Patsko/PTSK-MIDI-Switchboard-PCB/switchboard 2.brd

## EAGLE design switchboard 2.brd (2018-03-31)

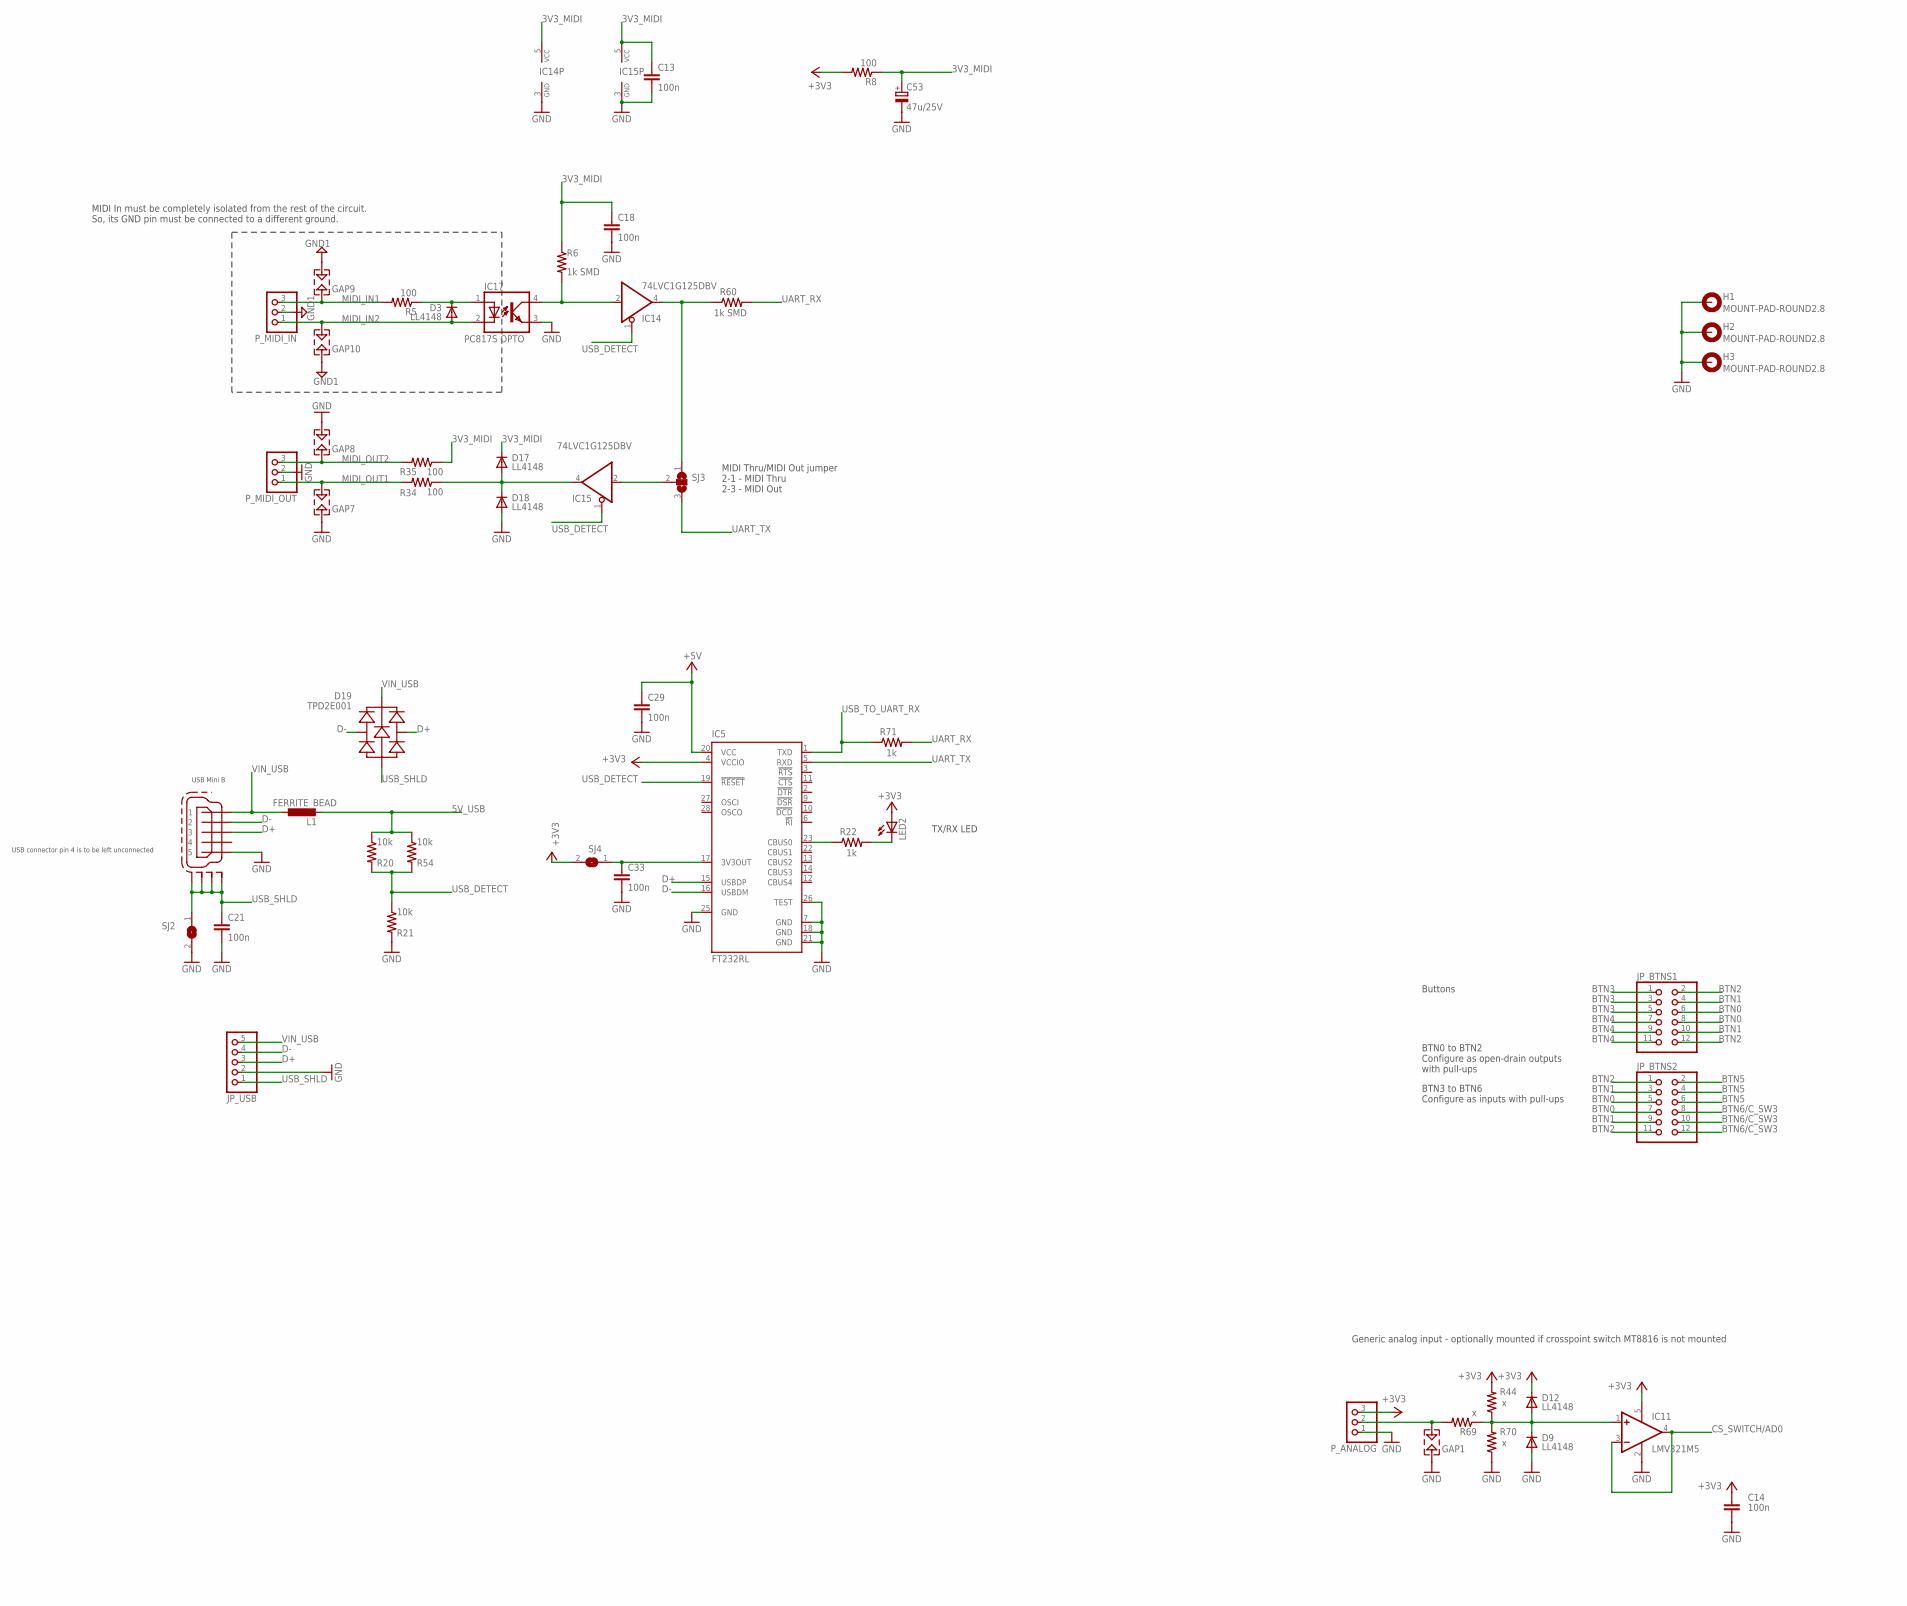
[picture p1: schematic switchboard 2.sch, part in row 1, column 1]

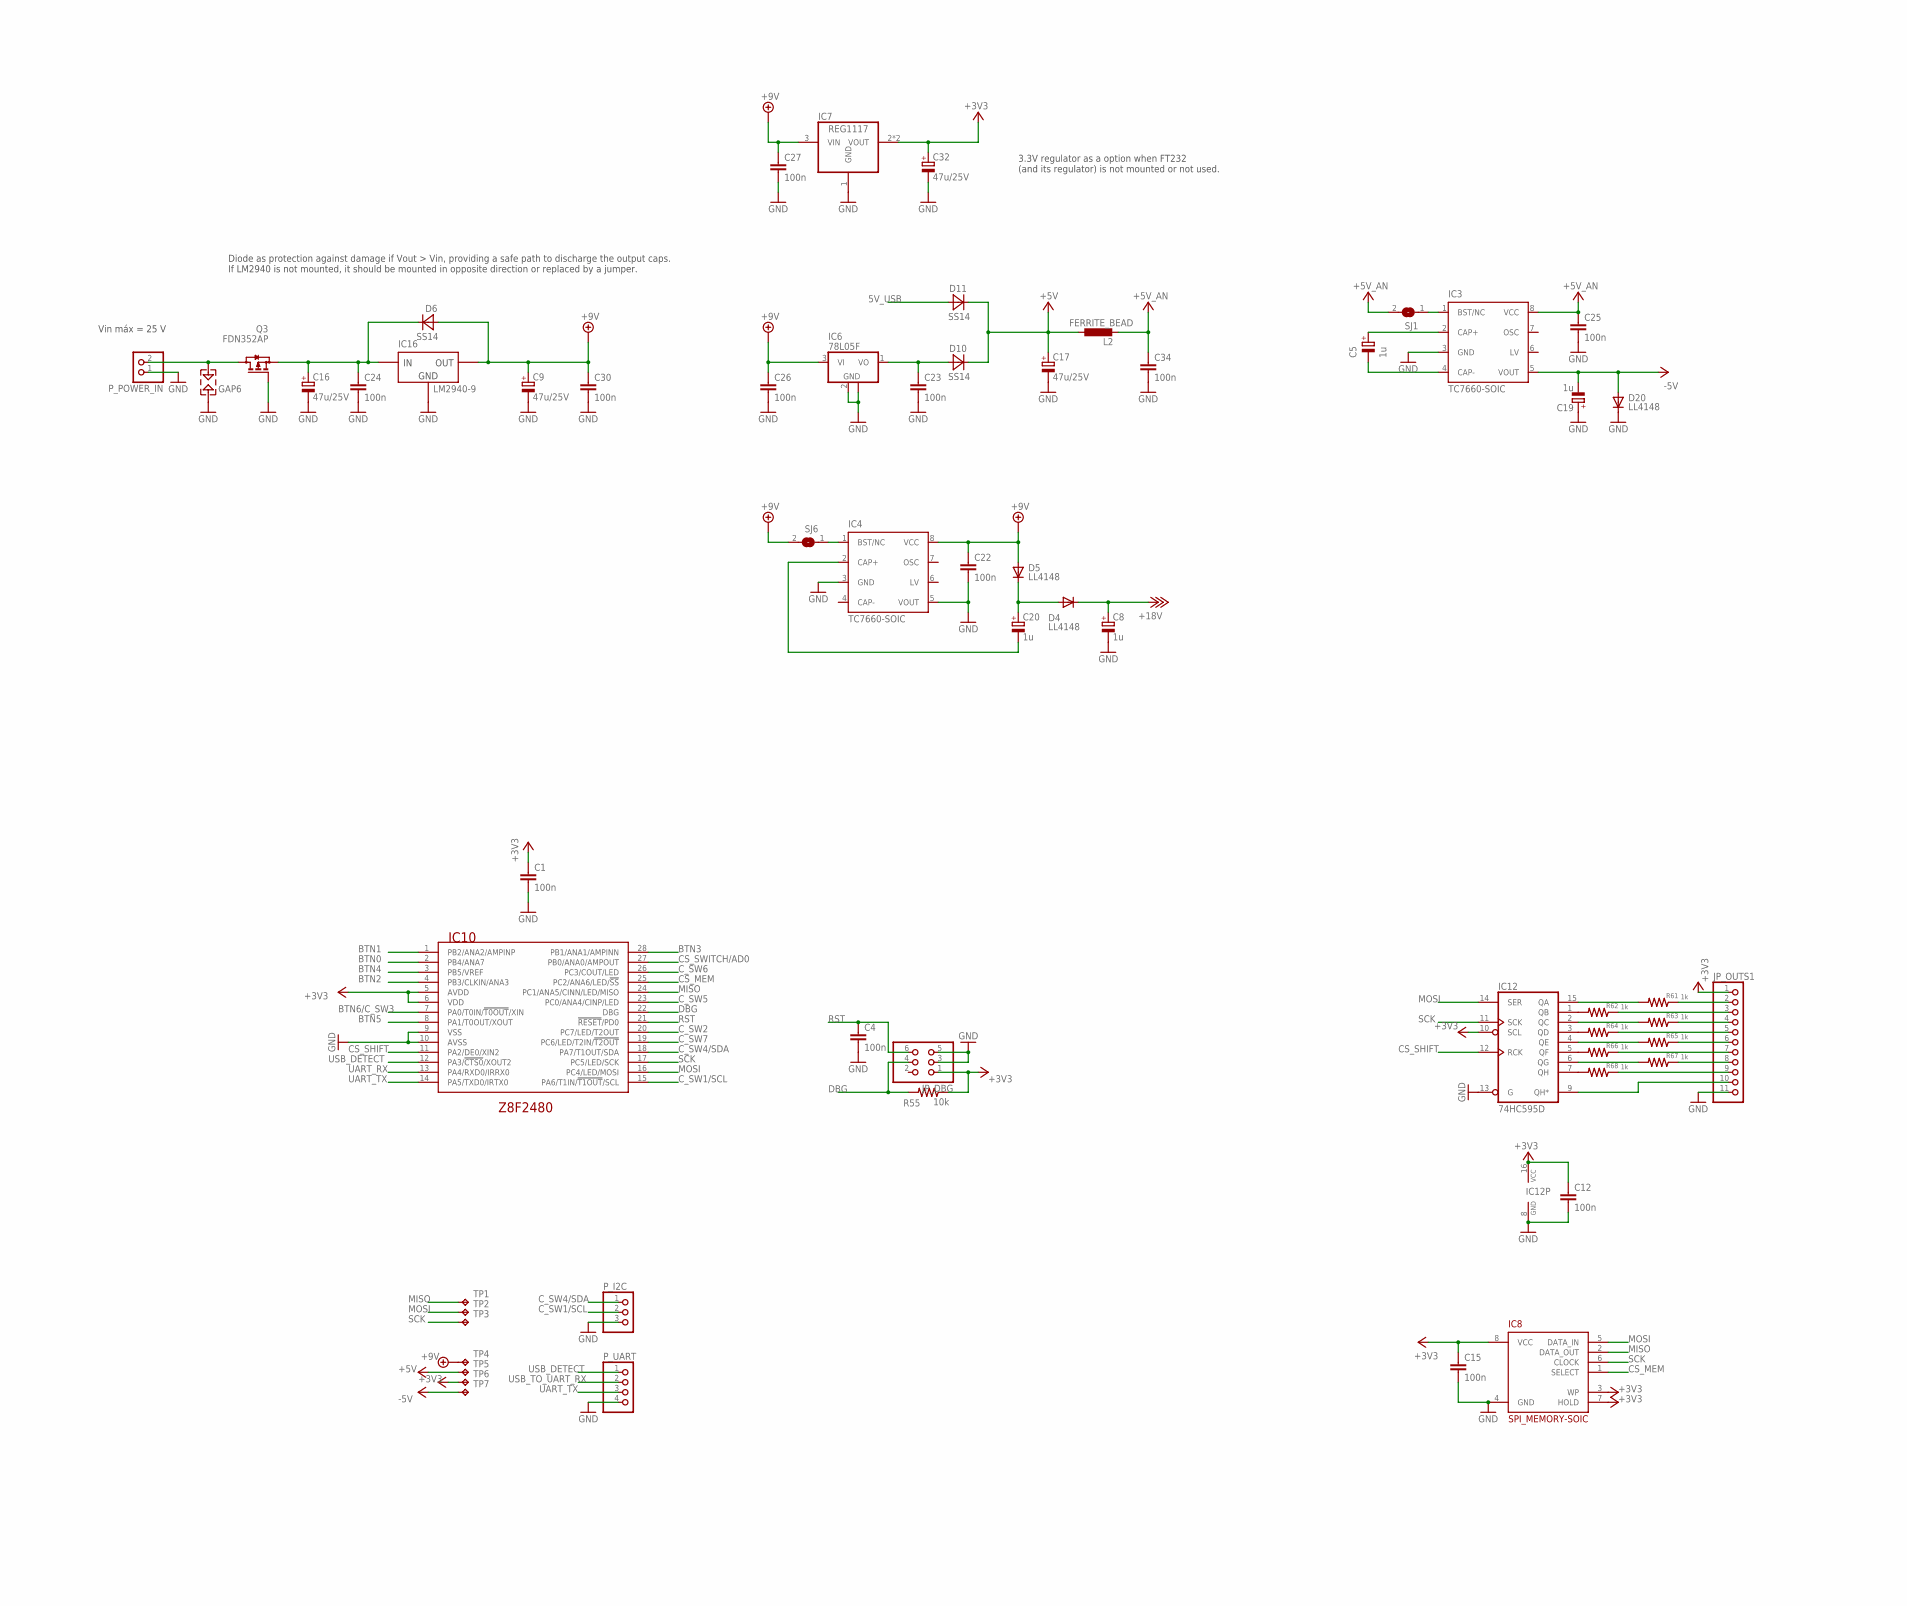
[picture p2: schematic switchboard 2.sch, part in row 1, column 2]

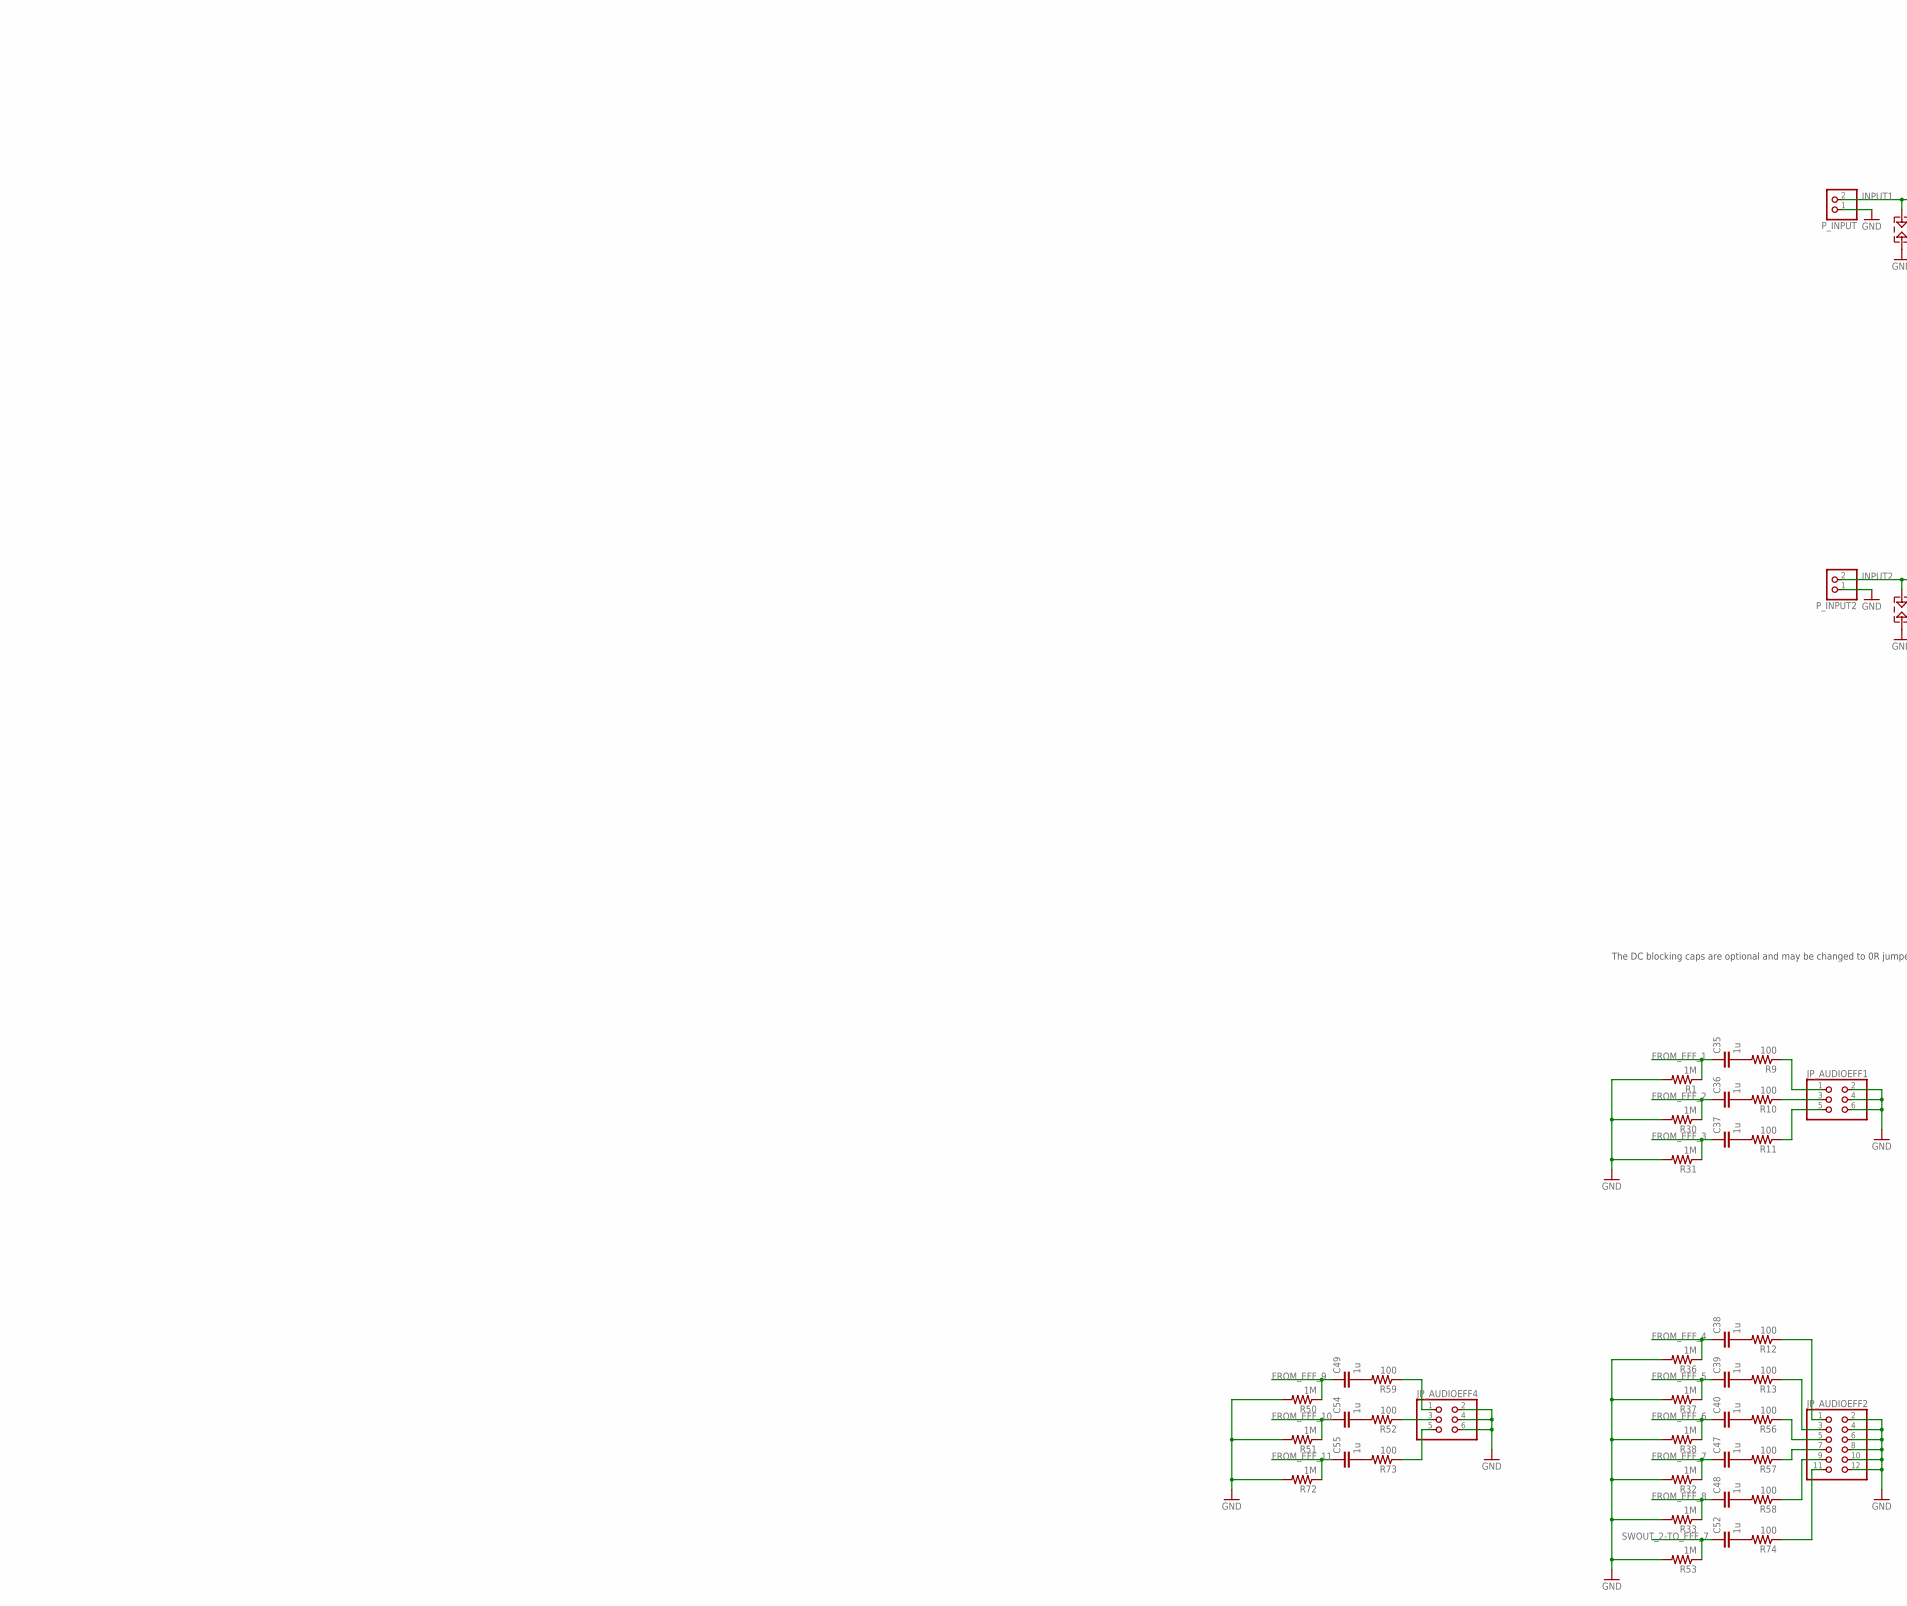
[picture p3: schematic switchboard 2.sch, part in row 2, column 1]

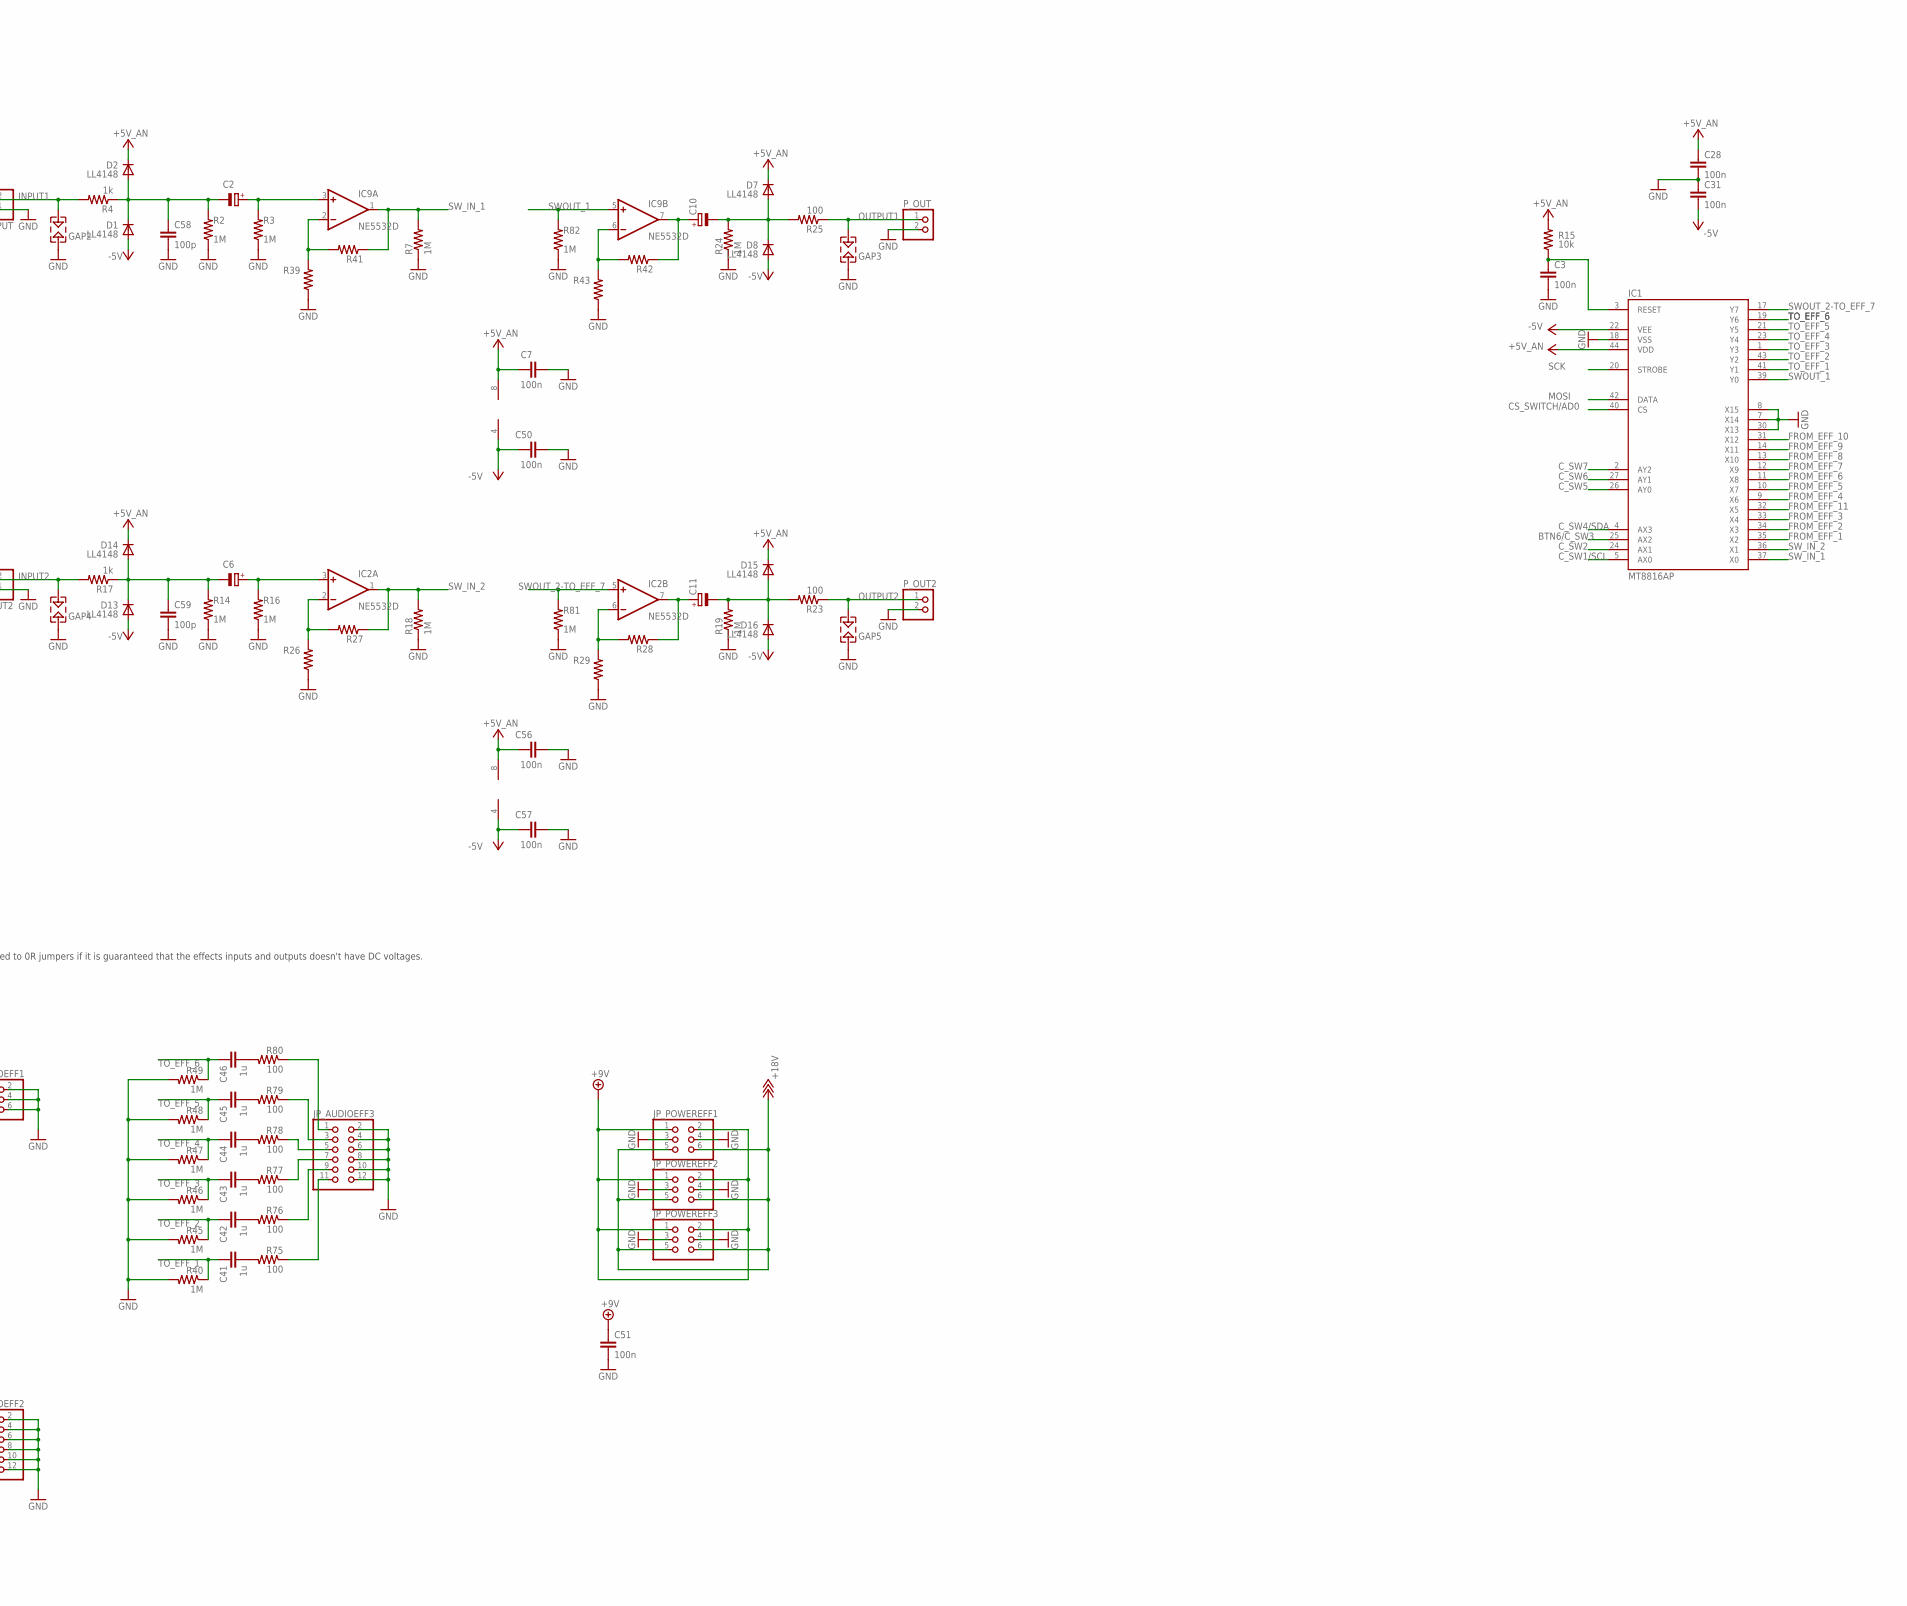
[picture p4: schematic switchboard 2.sch, part in row 2, column 2]

Parts:
C1, C3, C4, C7, C12, C13, C14, C15, C18, C26, C28, C29, C30, C31, C33, C50, C51, C56, C57: 100n; C0603
C2, C6, C10, C11: CAP_POL; SMB-SMA-0805-0603
C5, C8, C19, C20: 1u; SMB-SMA-0805-0603
C9, C16, C17, C32, C53: 47u/25V; ALUMINUM-TANTALUM-CAP
C21, C22, C23, C24, C25, C27, C34: 100n; C0805
C35, C36, C37, C38, C39, C40, C41, C42, C43, C44, C45, C46, C47, C48, C49, C52, C54, C55: 1u; C0603
C58, C59: 100p; C0603
D1, D2, D3, D4, D5, D7, D8, D9, D12, D13, D14, D15, D16, D17, D18, D20: LL4148; MINIMELF
D6, D10, D11: SS14; SMA
D19: TPD2E001; SOT143B
GAP1, GAP2, GAP3, GAP4, GAP5, GAP6, GAP7, GAP8, GAP9, GAP10: SPARK_GAP; SPARK-GAP-8
H1, H2, H3: MOUNT-PAD-ROUND2.8; 2,8-PAD
IC1: MT8816AP; PLCC44
IC2, IC9: NE5532D; SO08
IC3, IC4: TC7660-SOIC; SOIC08
IC5: FT232RL; SSOP28
IC6: 78L05F; SOT89
IC7: REG1117; SOT223
IC8: SPI_MEMORY-SOIC; SOIC08
IC10: Z8F2480SO; SO28W
IC11: LMV321M5; SOT23-5
IC12: 74HC595D; SO16
IC14, IC15: 74LVC1G125DBV; SOT23-5
IC16: LM2940-9; SOT223
IC17: PC817S OPTO; DIL4-SMD
JP_AUDIOEFF1, JP_AUDIOEFF4: PINHD-2X03_2.54-SMD; 2X03SMD
JP_AUDIOEFF2, JP_AUDIOEFF3: PINHD-2X06_2.54-SMD; 2X06SMD
JP_BTNS1, JP_BTNS2: PINHD-2X06_2.54-SMD; 2X06SMD
JP_DBG: PINHD-2X3; 2X03
JP_OUTS1: PINHD-1X11; 1X11
JP_POWEREFF1, JP_POWEREFF2, JP_POWEREFF3: PINHD-2X03_2.54-SMD; 2X03SMD
JP_USB: PINHD-1X5; 1X05
L1, L2: FERRITE_BEAD; 0805
LED2: LEDCHIPLED_0805; CHIPLED_0805
P_ANALOG: PINHD-1X3; 1X03
P_I2C: PINHD-1X3; 1X03
P_INPUT, P_INPUT2: PINHD-1X2; 1X02
P_MIDI_IN: PINHD-1X3; 1X03
P_MIDI_OUT: PINHD-1X3; 1X03
P_OUT, P_OUT2: PINHD-1X2; 1X02
P_POWER_IN: PINHD-1X2; 1X02
P_UART: PINHD-1X4; 1X04
Q3: FDN352AP; SOT23
R1, R2, R3, R7, R14, R16, R18, R19, R24, R30, R31, R32, R33, R36, R37, R38, R40, R45, R46, R47, R48, R49, R50, R51, R53, R72, R81, R82: 1M; R0603
R4, R17, R22, R61, R62, R63, R64, R65, R66, R67, R68, R71: 1k; R0603
R5, R8, R9, R10, R11, R12, R13, R23, R25, R34, R35, R52, R56, R57, R58, R59, R73, R74, R75, R76, R77, R78, R79, R80: 100; R0603
R6, R60: 1k SMD; R0603
R15, R20, R21, R54, R55: 10k; R0603
R26, R27, R28, R29, R39, R41, R42, R43: 1M SMD; R0603
R44, R69, R70: x; R0603
SJ1, SJ2, SJ4, SJ6: SJ
SJ3: SJ2W; SJ_2
TP1, TP2, TP3, TP4, TP5, TP6, TP7: TPB1,27; B1,27
X1: MINI-USB-SCHIELD-32005-301; 32005-301

Connections:
3V3_MIDI: C13.1, C18.1, C53.+, D17.C, IC14.5 (VCC), IC15.5 (VCC), R6.1, R8.1, R35.1
5V_USB: D11.A, L1.2, R20.1, R54.1
+3V3: C1.1, C12.1, C14.1, C15.1, C32.+, D12.C, IC5.4 (VCCIO), IC7.2 (VOUT), IC7.TAB (VOUT), IC8.3 (WP), IC8.7 (HOLD), IC8.8 (VCC), IC10.5 (AVDD), IC10.6 (VDD), IC11.5 (V+), IC12.10 (SCL), IC12.16 (VCC), JP_DBG.1, JP_OUTS1.1, LED2.A, P_ANALOG.3, R8.2, R44.2, R55.1, SJ4.2, TP6.TP
+5V: C17.+, C29.1, D10.C, D11.C, IC5.20 (VCC), L2.1, TP5.TP
+5V_AN: C7.1, C25.1, C28.1, C34.1, C56.1, D2.C, D7.C, D14.C, D15.C, IC1.44 (VDD), IC2.8 (V+), IC3.8 (VCC), IC9.8 (V+), L2.2, R15.2, SJ1.2
+9V: C9.+, C22.1, C26.1, C27.1, C30.1, C51.1, D5.A, D6.A, IC4.8 (VCC), IC6.3 (VI), IC7.3 (VIN), IC16.3 (OUT), JP_POWEREFF1.1, JP_POWEREFF1.2, JP_POWEREFF2.1, JP_POWEREFF2.2, JP_POWEREFF3.1, JP_POWEREFF3.2, SJ6.2, TP4.TP
+18V: C8.+, D4.C, JP_POWEREFF1.5, JP_POWEREFF1.6, JP_POWEREFF2.5, JP_POWEREFF2.6, JP_POWEREFF3.5, JP_POWEREFF3.6
-5V: C19.-, C31.2, C50.1, C57.1, D1.A, D8.A, D13.A, D16.A, D20.A, IC1.22 (VEE), IC2.4 (V-), IC3.5 (VOUT), IC9.4 (V-), TP7.TP
AD0: D9.C, D12.A, IC11.1 (+IN), R44.1, R69.1, R70.2
BTN0: IC10.2 (PB4/ANA7), JP_BTNS1.6, JP_BTNS1.8, JP_BTNS2.5, JP_BTNS2.7
BTN1: IC10.1 (PB2/ANA2/AMPINP), JP_BTNS1.4, JP_BTNS1.10, JP_BTNS2.3, JP_BTNS2.9
BTN2: IC10.4 (PB3/CLKIN/ANA3), JP_BTNS1.2, JP_BTNS1.12, JP_BTNS2.1, JP_BTNS2.11
BTN3: IC10.28 (PB1/ANA1/AMPINN), JP_BTNS1.1, JP_BTNS1.3, JP_BTNS1.5
BTN4: IC10.3 (PB5/VREF), JP_BTNS1.7, JP_BTNS1.9, JP_BTNS1.11
BTN5: IC10.8 (PA1/T0OUT/XOUT), JP_BTNS2.2, JP_BTNS2.4, JP_BTNS2.6
BTN6/C_SW3: IC1.25 (AX2), IC10.7 (PA0/T0IN/!T0OUT!/XIN), JP_BTNS2.8, JP_BTNS2.10, JP_BTNS2.12
CS_MEM: IC8.1 (SELECT), IC10.25 (PC2/ANA6/LED/!SS)
CS_SHIFT: IC10.11 (PA2/DE0/XIN2), IC12.12 (RCK)
CS_SWITCH/AD0: IC1.40 (CS), IC10.27 (PB0/ANA0/AMPOUT), IC11.3 (-IN), IC11.4 (OUT)
C_SW1/SCL: IC1.5 (AX0), IC10.15 (PA6/T1IN/!T1OUT!/SCL), P_I2C.2
C_SW2: IC1.24 (AX1), IC10.20 (PC7/LED/T2OUT)
C_SW4/SDA: IC1.4 (AX3), IC10.18 (PA7/T1OUT/SDA), P_I2C.1
C_SW5: IC1.26 (AY0), IC10.23 (PC0/ANA4/CINP/LED)
C_SW6: IC1.27 (AY1), IC10.26 (PC3/COUT/LED)
C_SW7: IC1.2 (AY2), IC10.19 (PC6/LED/T2IN/!T2OUT!)
D+: D19.3 (IO2), IC5.15 (USBDP), JP_USB.3, X1.3
D-: D19.2 (IO1), IC5.16 (USBDM), JP_USB.4, X1.2
DBG: IC10.22 (DBG), JP_DBG.4, R55.2
FROM_EFF_1: C35.1, IC1.35 (X2), R1.1
FROM_EFF_2: C36.1, IC1.34 (X3), R30.1
FROM_EFF_3: C37.1, IC1.33 (X4), R31.1
FROM_EFF_4: C38.1, IC1.9 (X6), R36.1
FROM_EFF_5: C39.1, IC1.10 (X7), R37.1
FROM_EFF_6: C40.1, IC1.11 (X8), R38.1
FROM_EFF_7: C47.1, IC1.12 (X9), R32.1
FROM_EFF_8: C48.1, IC1.13 (X10), R33.1
FROM_EFF_9: C49.1, IC1.14 (X11), R50.1
FROM_EFF_10: C54.1, IC1.31 (X12), R51.1
FROM_EFF_11: C55.1, IC1.32 (X5), R72.1
GND: C1.2, C3.2, C4.2, C7.2, C8.-, C9.-, C12.2, C13.2, C14.2, C15.2, C16.-, C17.-, C18.2, C19.+, C21.2, C22.2, C23.2, C24.2, C25.2, C26.2, C27.2, C28.2, C29.2, C30.2, C31.1, C32.-, C33.2, C34.2, C50.2, C51.2, C53.-, C56.2, C57.2, C58.2, C59.2, D9.A, D18.A, D20.C, GAP1.P$2 (2), GAP2.P$2 (2), GAP3.P$2 (2), GAP4.P$2 (2), GAP5.P$2 (2), GAP6.P$2 (2), GAP7.P$2 (2), GAP8.P$1 (1), H1.B2,8, H2.B2,8, H3.B2,8, IC1.7 (X14), IC1.8 (X15), IC1.18 (VSS), IC1.30 (X13), IC3.3 (GND), IC4.3 (GND), IC4.5 (VOUT), IC5.7 (GND), IC5.18 (GND), IC5.21 (GND), IC5.25 (GND), IC5.26 (TEST), IC6.2 (GND), IC6.2@1 (GND), IC7.1 (GND), IC8.4 (GND), IC10.9 (VSS), IC10.10 (AVSS), IC11.2 (V-), IC12.8 (GND), IC12.13 (G), IC14.3 (GND), IC15.3 (GND), IC16.2 (GND), IC16.TAB (GND), IC17.3 (EMIT), JP_AUDIOEFF1.2, JP_AUDIOEFF1.4, JP_AUDIOEFF1.6, JP_AUDIOEFF2.2, JP_AUDIOEFF2.4, JP_AUDIOEFF2.6, JP_AUDIOEFF2.8, JP_AUDIOEFF2.10, JP_AUDIOEFF2.12, JP_AUDIOEFF3.2, JP_AUDIOEFF3.4, JP_AUDIOEFF3.6, JP_AUDIOEFF3.8, JP_AUDIOEFF3.10, JP_AUDIOEFF3.12, JP_AUDIOEFF4.2, JP_AUDIOEFF4.4, JP_AUDIOEFF4.6, JP_DBG.3, JP_DBG.5, JP_OUTS1.11, JP_POWEREFF1.3, JP_POWEREFF1.4, JP_POWEREFF2.3, JP_POWEREFF2.4, JP_POWEREFF3.3, JP_POWEREFF3.4, JP_USB.2, P_ANALOG.1, P_I2C.3, P_INPUT.1, P_INPUT2.1, P_MIDI_OUT.2, P_OUT.2, P_OUT2.2, P_POWER_IN.1, P_UART.4, Q3.1 (G), R1.2, R2.1, R3.1, R7.1, R14.1, R16.1, R18.1, R19.1, R21.2, R24.1, R26.1, R29.1, R30.2, R31.2, R32.2, R33.2, R36.2, R37.2, R38.2, R39.1, R40.2, R43.1, R45.2, R46.2, R47.2, R48.2, R49.2, R50.2, R51.2, R53.2, R70.1, R72.2, R81.1, R82.1, SJ2.2, X1.5
GND1: GAP9.P$1 (1), GAP10.P$2 (2), P_MIDI_IN.2
INPUT1: GAP2.P$1 (1), P_INPUT.2, R4.2
INPUT2: GAP4.P$1 (1), P_INPUT2.2, R17.2
MIDI_IN1: GAP9.P$2 (2), P_MIDI_IN.3, R5.2
MIDI_IN2: D3.A, GAP10.P$1 (1), IC17.2 (C), P_MIDI_IN.1
MIDI_OUT1: GAP7.P$1 (1), P_MIDI_OUT.1, R34.2
MIDI_OUT2: GAP8.P$2 (2), P_MIDI_OUT.3, R35.2
MISO: IC8.2 (DATA_OUT), IC10.24 (PC1/ANA5/CINN/LED/MISO), TP1.TP
MOSI: IC1.42 (DATA), IC8.5 (DATA_IN), IC10.16 (PC4/LED/MOSI), IC12.14 (SER), TP2.TP
unnamed: IC9.2 (-IN), R39.2, R41.2
unnamed: D17.A, D18.C, IC15.4 (O), R34.1
unnamed: C2.+, IC9.3 (+IN), R3.2
unnamed: C2.-, C58.1, D1.C, D2.A, R2.2, R4.1
unnamed: IC3.1 (BST/NC), SJ1.1
unnamed: IC4.1 (BST/NC), SJ6.1
unnamed: IC9.6 (-IN), R42.2, R43.2
unnamed: C10.+, IC9.7 (OUT), R42.1
unnamed: JP_AUDIOEFF2.1, R12.1
unnamed: C20.+, D4.A, D5.C
unnamed: C3.1, IC1.3 (RESET), R15.1
unnamed: JP_AUDIOEFF1.1, R9.1
unnamed: C23.1, D10.A, IC6.1 (VO)
unnamed: C10.-, D7.A, D8.C, R24.2, R25.2
unnamed: C35.2, R9.2
unnamed: C36.2, R10.2
unnamed: C37.2, R11.2
unnamed: C38.2, R12.2
unnamed: C54.2, R52.2
unnamed: IC12.15 (QA), R61.2
unnamed: JP_AUDIOEFF3.11, R75.1
unnamed: IC12.1 (QB), R62.2
unnamed: IC12.2 (QC), R63.2
unnamed: IC12.3 (QD), R64.2
unnamed: C16.+, C24.1, D6.C, IC16.1 (IN), Q3.2 (S)
unnamed: IC12.4 (QE), R65.2
unnamed: C6.+, IC2.3 (+IN), R16.2
unnamed: D3.C, IC17.1 (A), R5.1
unnamed: IC12.5 (QF), R66.2
unnamed: IC12.6 (QG), R67.2
unnamed: IC12.7 (QH), R68.2
unnamed: JP_AUDIOEFF3.9, R76.1
unnamed: LED2.C, R22.2
unnamed: GAP1.P$1 (1), P_ANALOG.2, R69.2
unnamed: C33.1, IC5.17 (3V3OUT), SJ4.1
unnamed: JP_OUTS1.2, R61.1
unnamed: JP_OUTS1.3, R62.1
unnamed: JP_OUTS1.4, R63.1
unnamed: JP_OUTS1.5, R64.1
unnamed: JP_OUTS1.6, R65.1
unnamed: JP_OUTS1.7, R66.1
unnamed: JP_OUTS1.8, R67.1
unnamed: JP_OUTS1.9, R68.1
unnamed: IC12.9 (QH*), JP_OUTS1.10
unnamed: IC5.23 (CBUS0), R22.1
unnamed: C5.+, IC3.2 (CAP+)
unnamed: C5.-, IC3.4 (CAP-)
unnamed: GAP6.P$1 (1), P_POWER_IN.2, Q3.3 (D)
unnamed: C39.2, R13.2
unnamed: C40.2, R56.2
unnamed: C47.2, R57.2
unnamed: JP_AUDIOEFF3.7, R77.1
unnamed: JP_AUDIOEFF3.5, R78.1
unnamed: C6.-, C59.1, D13.C, D14.A, R14.2, R17.1
unnamed: C11.+, IC2.7 (OUT), R28.1
unnamed: C11.-, D15.A, D16.C, R19.2, R23.2
unnamed: IC2.2 (-IN), R26.2, R27.2
unnamed: IC2.6 (-IN), R28.2, R29.2
unnamed: JP_AUDIOEFF3.3, R79.1
unnamed: C20.-, IC4.2 (CAP+)
unnamed: IC15.2 (I), SJ3.2
unnamed: JP_AUDIOEFF3.1, R80.1
unnamed: C48.2, R58.2
unnamed: C55.2, R73.2
unnamed: C49.2, R59.2
unnamed: JP_AUDIOEFF2.11, R74.1
unnamed: JP_AUDIOEFF4.5, R73.1
unnamed: C52.2, R74.2
unnamed: JP_AUDIOEFF1.3, R10.1
unnamed: JP_AUDIOEFF4.3, R52.1
unnamed: JP_AUDIOEFF4.1, R59.1
unnamed: JP_AUDIOEFF1.5, R11.1
unnamed: JP_AUDIOEFF2.3, R13.1
unnamed: JP_AUDIOEFF2.9, R58.1
unnamed: JP_AUDIOEFF2.5, R56.1
unnamed: JP_AUDIOEFF2.7, R57.1
unnamed: C43.2, R77.2
unnamed: C41.2, R75.2
unnamed: C42.2, R76.2
unnamed: C44.2, R78.2
unnamed: C45.2, R79.2
unnamed: C46.2, R80.2
unnamed: IC14.4 (O), R60.1, SJ3.1
unnamed: IC14.2 (I), IC17.4 (COL), R6.2
OUTPUT1: GAP3.P$1 (1), P_OUT.1, R25.1
OUTPUT2: GAP5.P$1 (1), P_OUT2.1, R23.1
RST: C4.1, IC10.21 (!RESET!/PD0), JP_DBG.6
SCK: IC1.20 (STROBE), IC8.6 (CLOCK), IC10.17 (PC5/LED/SCK), IC12.11 (SCK), TP3.TP
SWOUT_1: IC1.39 (Y0), IC9.5 (+IN), R82.2
SWOUT_2-TO_EFF_7: C52.1, IC1.17 (Y7), IC2.5 (+IN), R53.1, R81.2
SW_IN_1: IC1.37 (X0), IC9.1 (OUT), R7.2, R41.1
SW_IN_2: IC1.36 (X1), IC2.1 (OUT), R18.2, R27.1
TO_EFF_1: C41.1, IC1.41 (Y1), R40.1
TO_EFF_2: C42.1, IC1.43 (Y2), R45.1
TO_EFF_3: C43.1, IC1.1 (Y3), R46.1
TO_EFF_4: C44.1, IC1.23 (Y4), R47.1
TO_EFF_5: C45.1, IC1.21 (Y5), R48.1
TO_EFF_6: C46.1, IC1.19 (Y6), R49.1
UART_RX: IC10.13 (PA4/RXD0/IRRX0), R60.2, R71.2
UART_TX: IC5.5 (RXD), IC10.14 (PA5/TXD0/IRTX0), P_UART.3, SJ3.3
USB_DETECT: IC5.19 (!RESET), IC10.12 (PA3/!CTS0!/XOUT2), IC14.1 (OE), IC15.1 (OE), P_UART.1, R20.2, R21.1, R54.2
USB_SHLD: C21.1, D19.1 (GND), JP_USB.1, SJ2.1, X1.M1 (S1), X1.M2 (S2), X1.M3 (S3), X1.M4 (S4)
USB_TO_UART_RX: IC5.1 (TXD), P_UART.2, R71.1
VIN_USB: D19.4 (VCC), JP_USB.5, L1.1, X1.1

Notes on the sheet:
BTN0 to BTN2 Configure as open-drain outputs with pull-ups
BTN3 to BTN6 Configure as inputs with pull-ups
3.3V regulator as a option when FT232 (and its regulator) is not mounted or not used.
USB connector pin 4 is to be left unconnected
USB Mini B
Generic analog input - optionally mounted if crosspoint switch MT8816 is not mounted
MIDI Thru/MIDI Out jumper 2-1 - MIDI Thru 2-3 - MIDI Out
The DC blocking caps are optional and may be changed to 0R jumpers if it is guaranteed that the effects inputs and outputs doesn't have DC voltages.
TX/RX LED
Buttons
Diode as protection against damage if Vout > Vin, providing a safe path to discharge the output caps. If LM2940 is not mounted, it should be mounted in opposite direction or replaced by a jumper.
MIDI In must be completely isolated from the rest of the circuit. So, its GND pin must be connected to a different ground.
Vin máx = 25 V

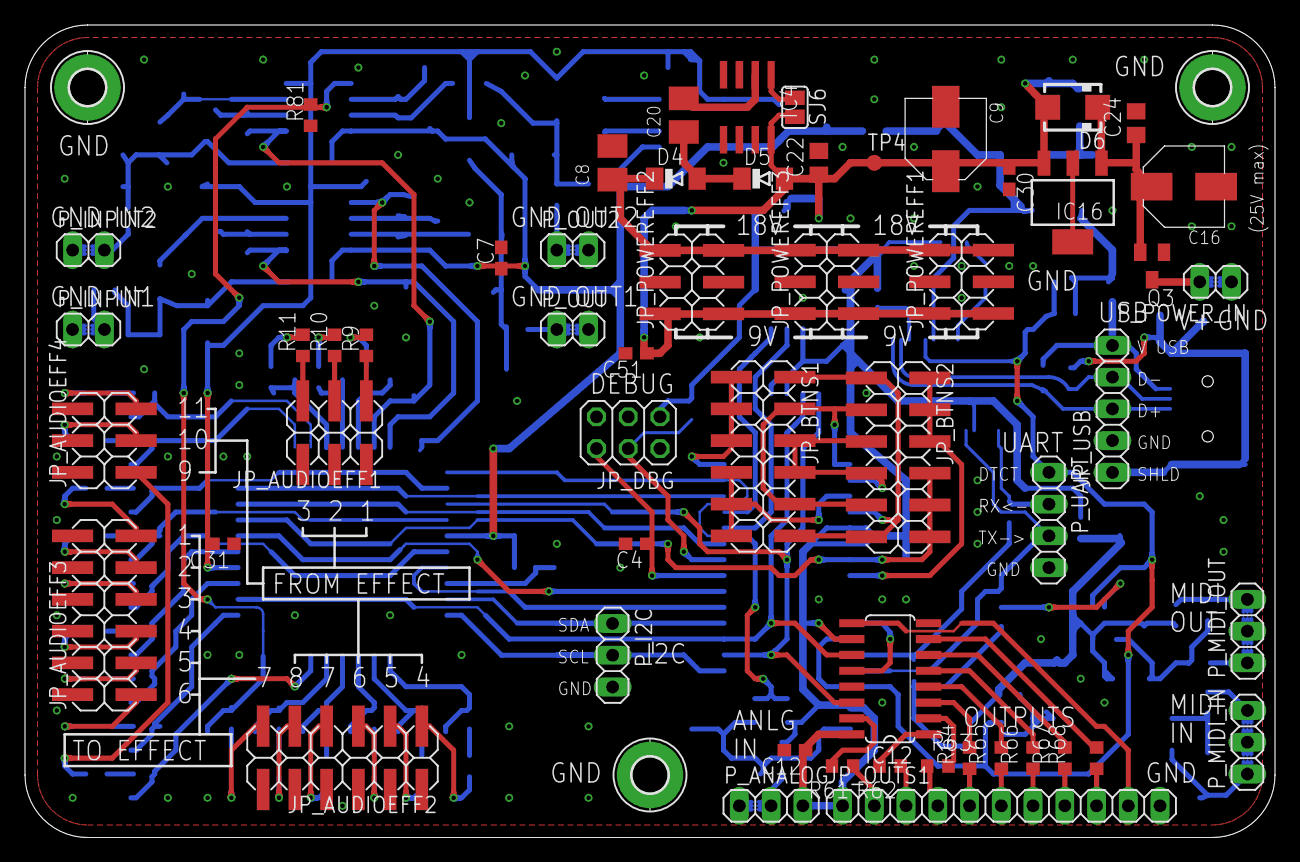
[picture p5: board switchboard 2.brd from above]

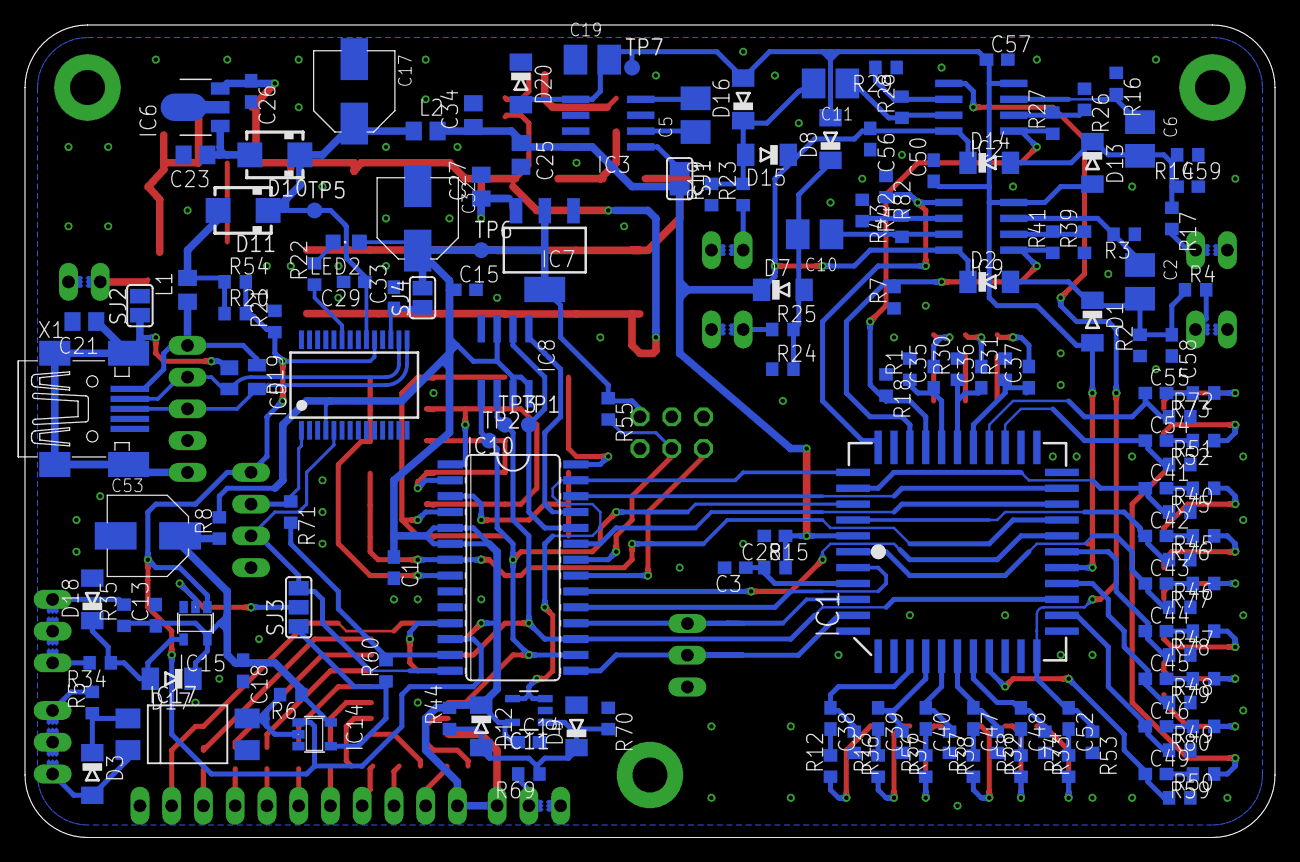
[picture p6: board switchboard 2.brd from below]

Board: 2 copper layers, 100.0 x 65.0 mm, 229 parts (171 on the bottom side), 153 nets.
