Patsko/PTSK-MIDI-Switchboard-PCB/(commit log)

2015-12-21 Commit inicial
    [switchboard 2.brd, switchboard 2.sch]
2015-12-22 Desenvolvimento do esquematico.
    [switchboard 2.brd, switchboard 2.sch]
2015-12-26 Conclusao geral do esquematico e inicio do desenvolvimento da placa.
    [switchboard 2.brd, switchboard 2.sch]
2015-12-29 Desenvolvimento do esquematico e placa
    [switchboard 2.brd, switchboard 2.sch]
2015-12-29 Alteracoes no projeto - remocao de dois efeitos do switchboard e seus componentes associados para chaveamento.
    [switchboard 2.brd, switchboard 2.sch]
2016-09-03 Alteraoes no layout
    [switchboard 2.brd, switchboard 2.sch]
2016-09-18 Desenvolvimento do esquematico: adicao de regulador ua78L05, alteracoes nos pinos do MCU, etc.
    [switchboard 2.brd, switchboard 2.sch]
2016-09-29 Desenvolvimento do esquematico: alteracao para uso de regulador zener para 3.3V, alteracoes no optoacoplador e circuito MIDI, etc.
    [switchboard 2.brd, switchboard 2.sch]
2016-12-03 Switch arrangement changed from 4053 to crosspoint switch.
    [switchboard 2.brd, switchboard 2.sch]
2016-12-04 Addition of MIDI Thru mounting option. Routing of crosspoint switch input and output signals.
    [switchboard 2.brd, switchboard 2.sch]
2016-12-08 Ajustes na alimentacao: troca de regulador zener por CJ1117, adicao de diodos OR para 5V, adicao de jumper de selecao para 3.3V, adicao de filtro para 5V analogico. Adicao de pinos para acesso aos si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
    [switchboard 2.brd, switchboard 2.sch]
2016-12-10 Input/output pinheaders and components added. Initial layout adjustments.
    [switchboard 2.brd, switchboard 2.sch]
2017-02-15 MCU Z8F082 dropped. Bidirectional MOSFET level shifter added. Reset signal added on debug connector.
    [switchboard 2.brd, switchboard 2.sch]
2017-04-21 General revisions and mods to the schematic - series resistors added to UART_RX, 3.3V selection jumper removed, USB_DETECT zener removed. Spark gaps added at audio inputs and outputs.
    [switchboard 2.brd, switchboard 2.sch]
2017-05-28 Polarity protection changed from series diode to PMOS. Pinheaders addded to access the MCU pins directly. V+ and Vcc power supply symbols changed to +9V and +5V_AN, respectively. Spark gaps added.
    [switchboard 2.brd, switchboard 2.sch]
2017-07-04 Signal names changed to clarify the direction to and from external effects.
    [switchboard 2.brd, switchboard 2.sch]
2017-07-17 Pull-ups on crosspoint address lines and voltage translator on SCK/MOSI removed.
    [switchboard 2.brd, switchboard 2.sch]
2018-01-09 Thru-hole pinheaders changed to SMD pinheaders.
    [switchboard 2.brd, switchboard 2.sch]
2018-01-09 RC filter added to MIDI 3V3 supply. GND1 added to connect the MIDI In cable shield.
    [switchboard 2.brd, switchboard 2.sch]
2018-01-18 Series resistors added to all audio effects inputs and outputs. Overvoltage protection added to audio and MIDI outputs. ESD protection added to MIDI inputs and outputs. USB_DETECT signal added to UAR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
    [switchboard 2.brd, switchboard 2.sch]
2018-01-23 ESD protection with TPD2E001 added to USB inputs.
    [switchboard 2.brd, switchboard 2.sch]
2018-01-27 Layout development. Minor component name and package changes.
    [switchboard 2.brd, switchboard 2.sch]
2018-02-01 Layout development.
    [switchboard 2.brd, switchboard 2.sch]
2018-02-05 Layout development. Board dimensions changed.
    [switchboard 2.brd, switchboard 2.sch]
2018-02-17 Layout development. Schematic changes to ease routing process. Some component package changes (mainly from 0805 to 0603).
    [switchboard 2.brd, switchboard 2.sch]
2018-02-23 Layout development and schematic changes to ease routing process.
    [switchboard 2.brd, switchboard 2.sch]
2018-03-03 Layout development. Ground planes added to top and bottom layers.
    [switchboard 2.brd, switchboard 2.sch]
2018-03-10 Polarity inversion protection diode added to -5V. USB ESD protection connection changed from GND to USB shield. Layout development and changes to improve performance, considering current loops.
    [switchboard 2.brd, switchboard 2.sch]
2018-03-12 Final adjustments to the schematic and layout. Cap added close to the generic input opamp. RC filter against EMI added to the audio inputs. Bias resistors added to output opamps.
    [switchboard 2.brd, switchboard 2.sch]
2018-03-17 Final adjustments. Test points added to SPI and supplies. PTSK Engineering text added (in solder mask stop layer).
    [switchboard 2.brd, switchboard 2.sch]
2018-03-29 Layout changes to improve manufacturability and EMC. RESET pin removed.
    [switchboard 2.brd, switchboard 2.sch]
2018-03-29 Teardrops added to vias.
    [switchboard 2.brd]
2018-03-31 Final adjustments. PLCC-44 and aluminum electrolytic cap packages updated.
    [switchboard 2.brd, switchboard 2.sch]
2018-03-31 Final adjustments. Signal identification added on silkscreen.
    [switchboard 2.brd]
2018-03-31 Final changes before manufacture: spark gaps changed from top to bottom layer, silkscreen changes due to differences between what Eagle displays and the gerber files generated, SMD pinheader packages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
    [switchboard 2.brd, switchboard 2.sch]
